WCP52/synthesizer/testing/steps.jpg

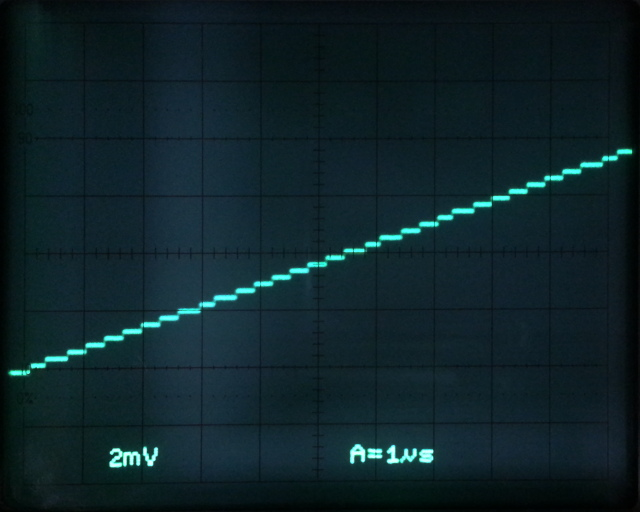
testing/steps.jpg
