WCP52/synthesizer/README.md

AD9958-based synthesizer board
==============================
