WCP52/synthesizer/pcb/renders/ad9958-dev_small.png

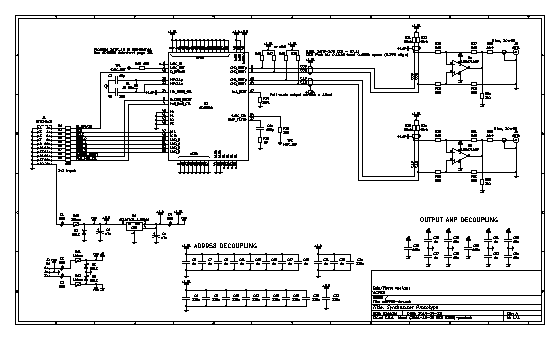
pcb/renders/ad9958-dev_small.png
