WCP52/synthesizer/pcb/renders/page_ad9958-dev.png

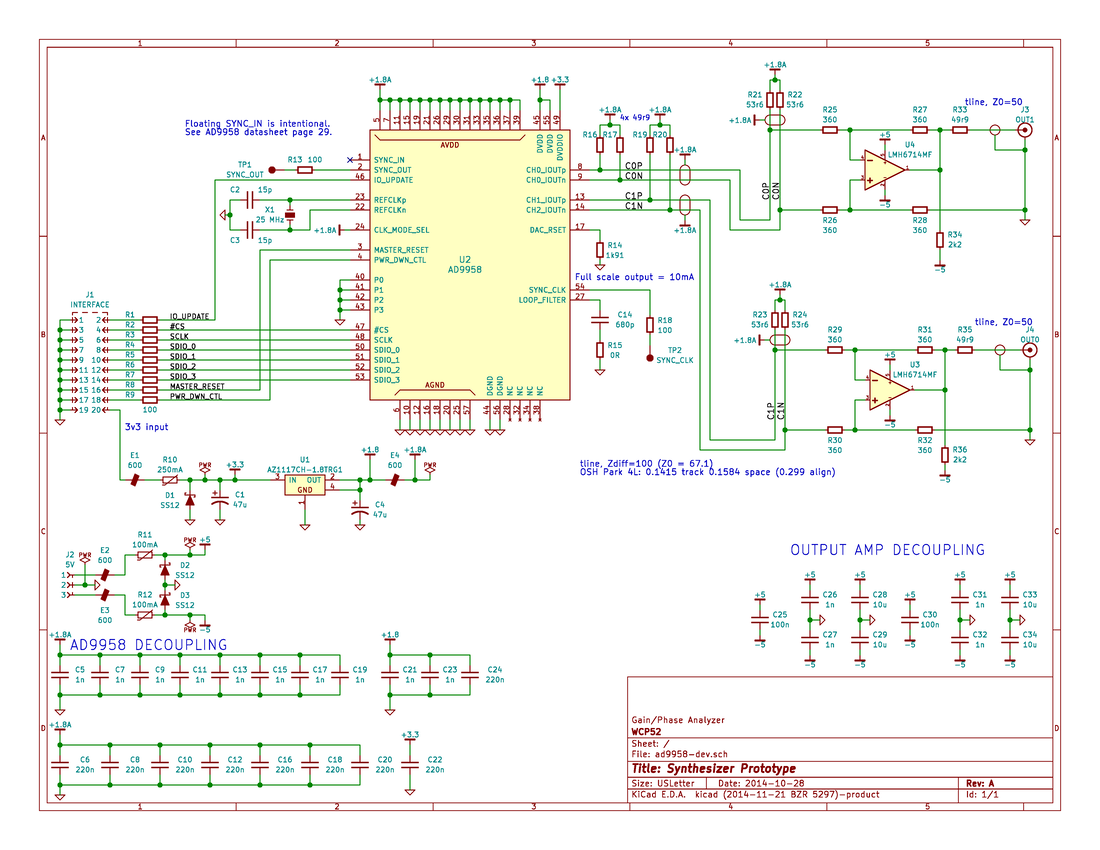
pcb/renders/page_ad9958-dev.png
