WCP52/synthesizer/pcb/renders/render_2l.png

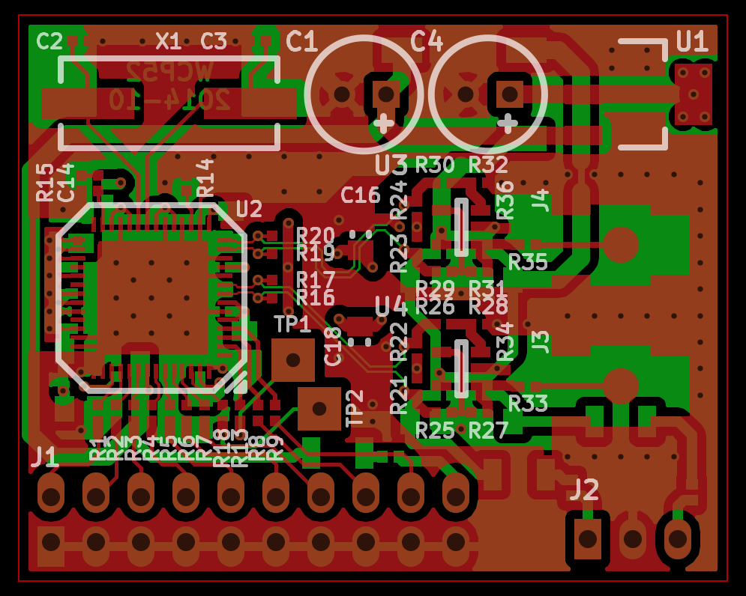
pcb/renders/render_2l.png
