WCP52/synthesizer/pcb/renders/render_3d_small.png

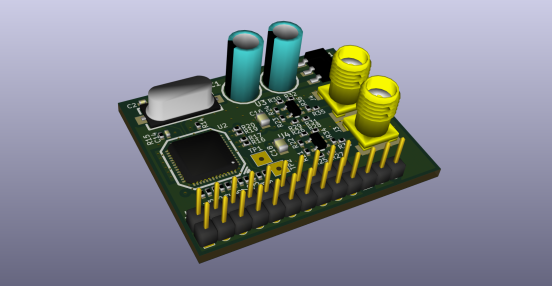
pcb/renders/render_3d_small.png
