WCP52/synthesizer/pcb/renders/render_lyr1.png

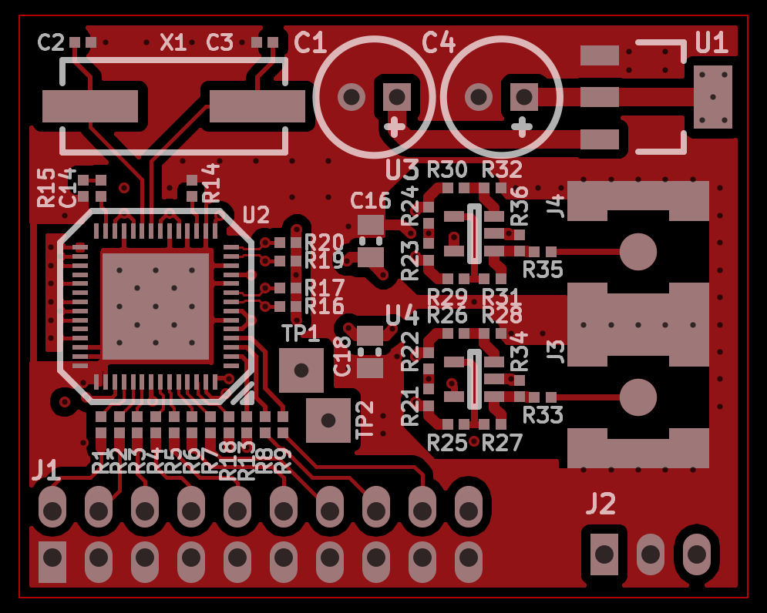
pcb/renders/render_lyr1.png
