WCP52/synthesizer/pcb/renders/render_lyr2.png

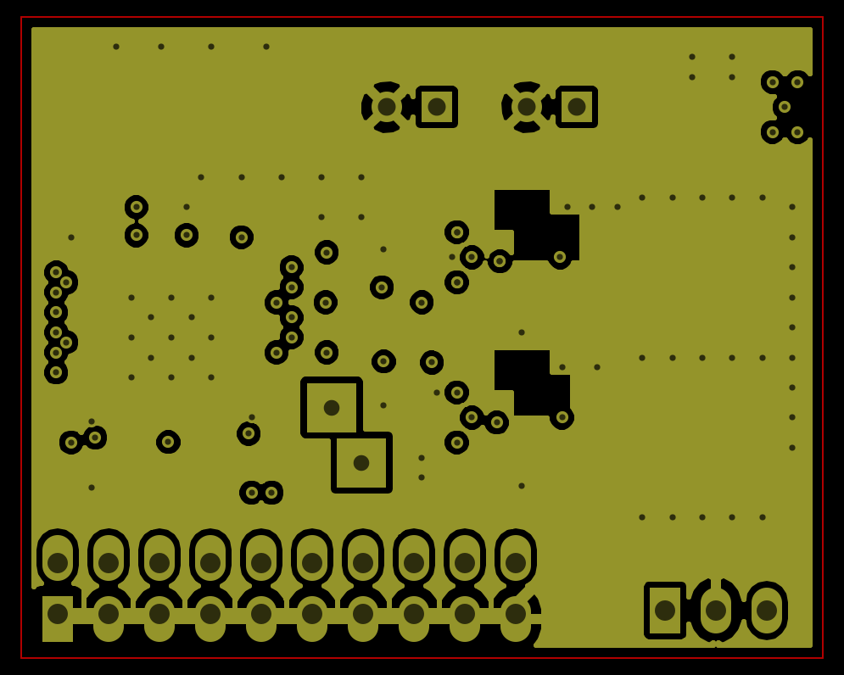
pcb/renders/render_lyr2.png
