WCP52/synthesizer/pcb/renders/render_lyr3.png

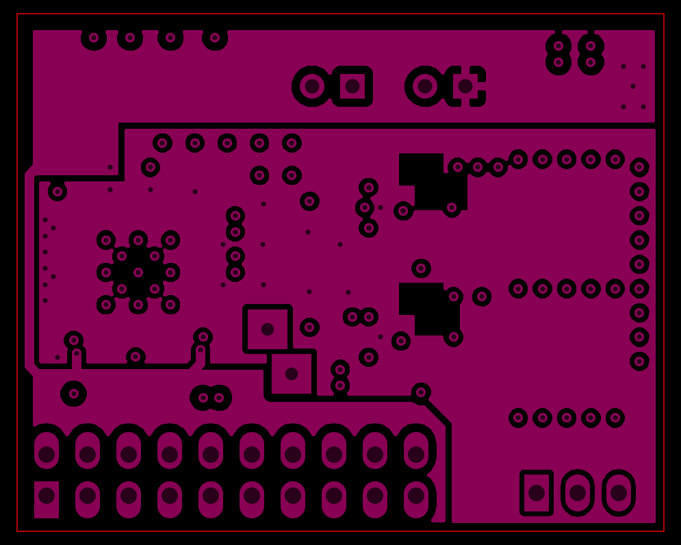
pcb/renders/render_lyr3.png
