WCP52/synthesizer/pcb/renders/render_lyr4.png

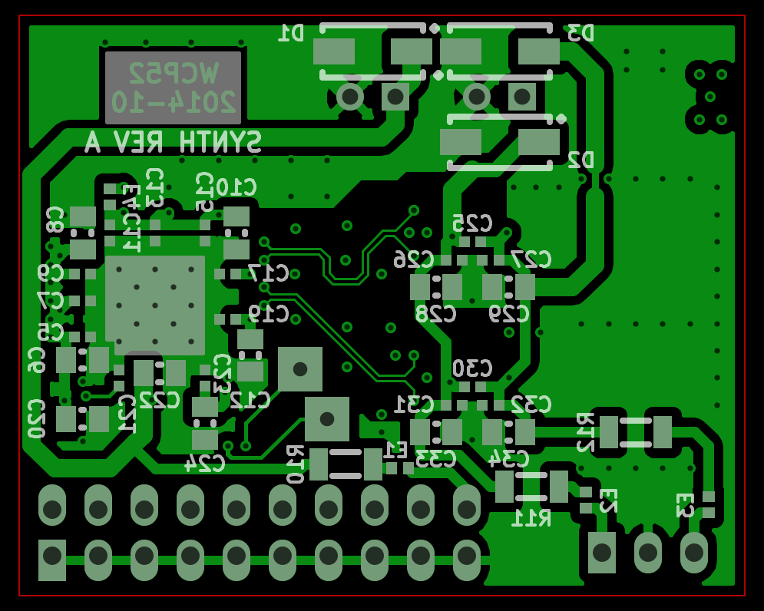
pcb/renders/render_lyr4.png
