WCP52/synthesizer/pcb/renders/schematic_small.png

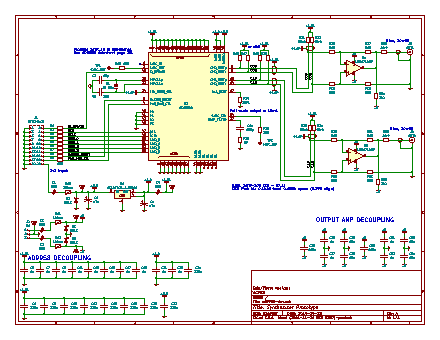
pcb/renders/schematic_small.png
