WCP52/synthesizer/pcb/renders/schematic.pdf

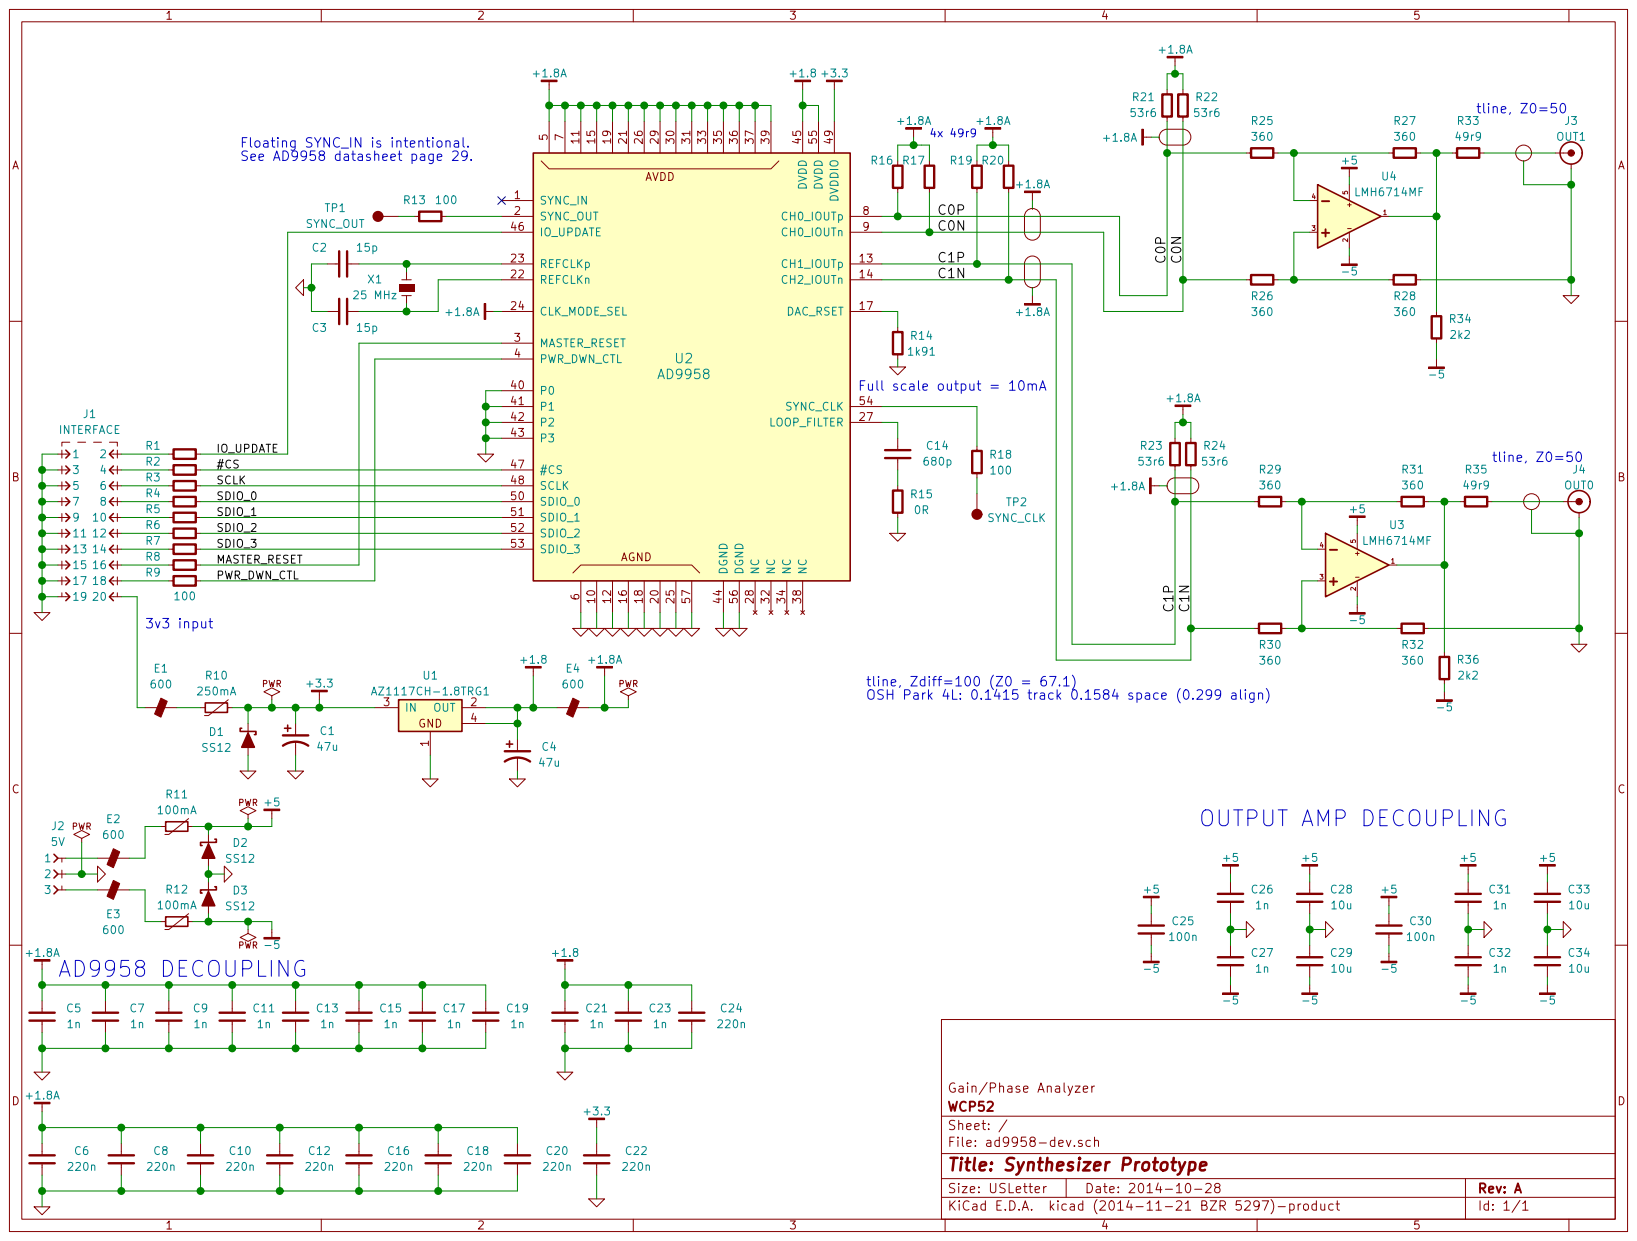
[picture p11: page 1]
