WCP52/synthesizer/sim/Draft1.asc

I1: load2; SINE(5m 5m {freq}); AC 1; load
I2: load2; SINE(5m 5m {freq} 0 0 180); AC 1 180; load
R1: res; 53.6
R2: res; 360
R3: res; 360
R4: res; 2k2
R5: res; 53.6
R11: res; 49.9
R14: res; 49.9
R17: res; 360
R19: res; 360
R20: res; 50
R21: res; 50
T2: tline; Td=1n Z0=100
U1: LMH6720
V1: voltage; 3.3
V2: voltage; 1.8
V3: voltage; 5
V4: voltage; -5
V6: voltage; 1.3
Named nets: 0, +3V3, +1V8, comp_limit, +5, -5, chp, chn, oa_inn, oa_inp, out
.tran {10/freq} uic
;ac dec 500 10 1G
;step param freq list 200 2k 20k 200k 2Meg 20Meg 200Meg
.param freq 200Meg
