WCP52/synthesizer/pcb/ad9958-dev.kicad_pcb

## KiCad design pcb/ad9958-dev.kicad_pcb (2014-11-11)

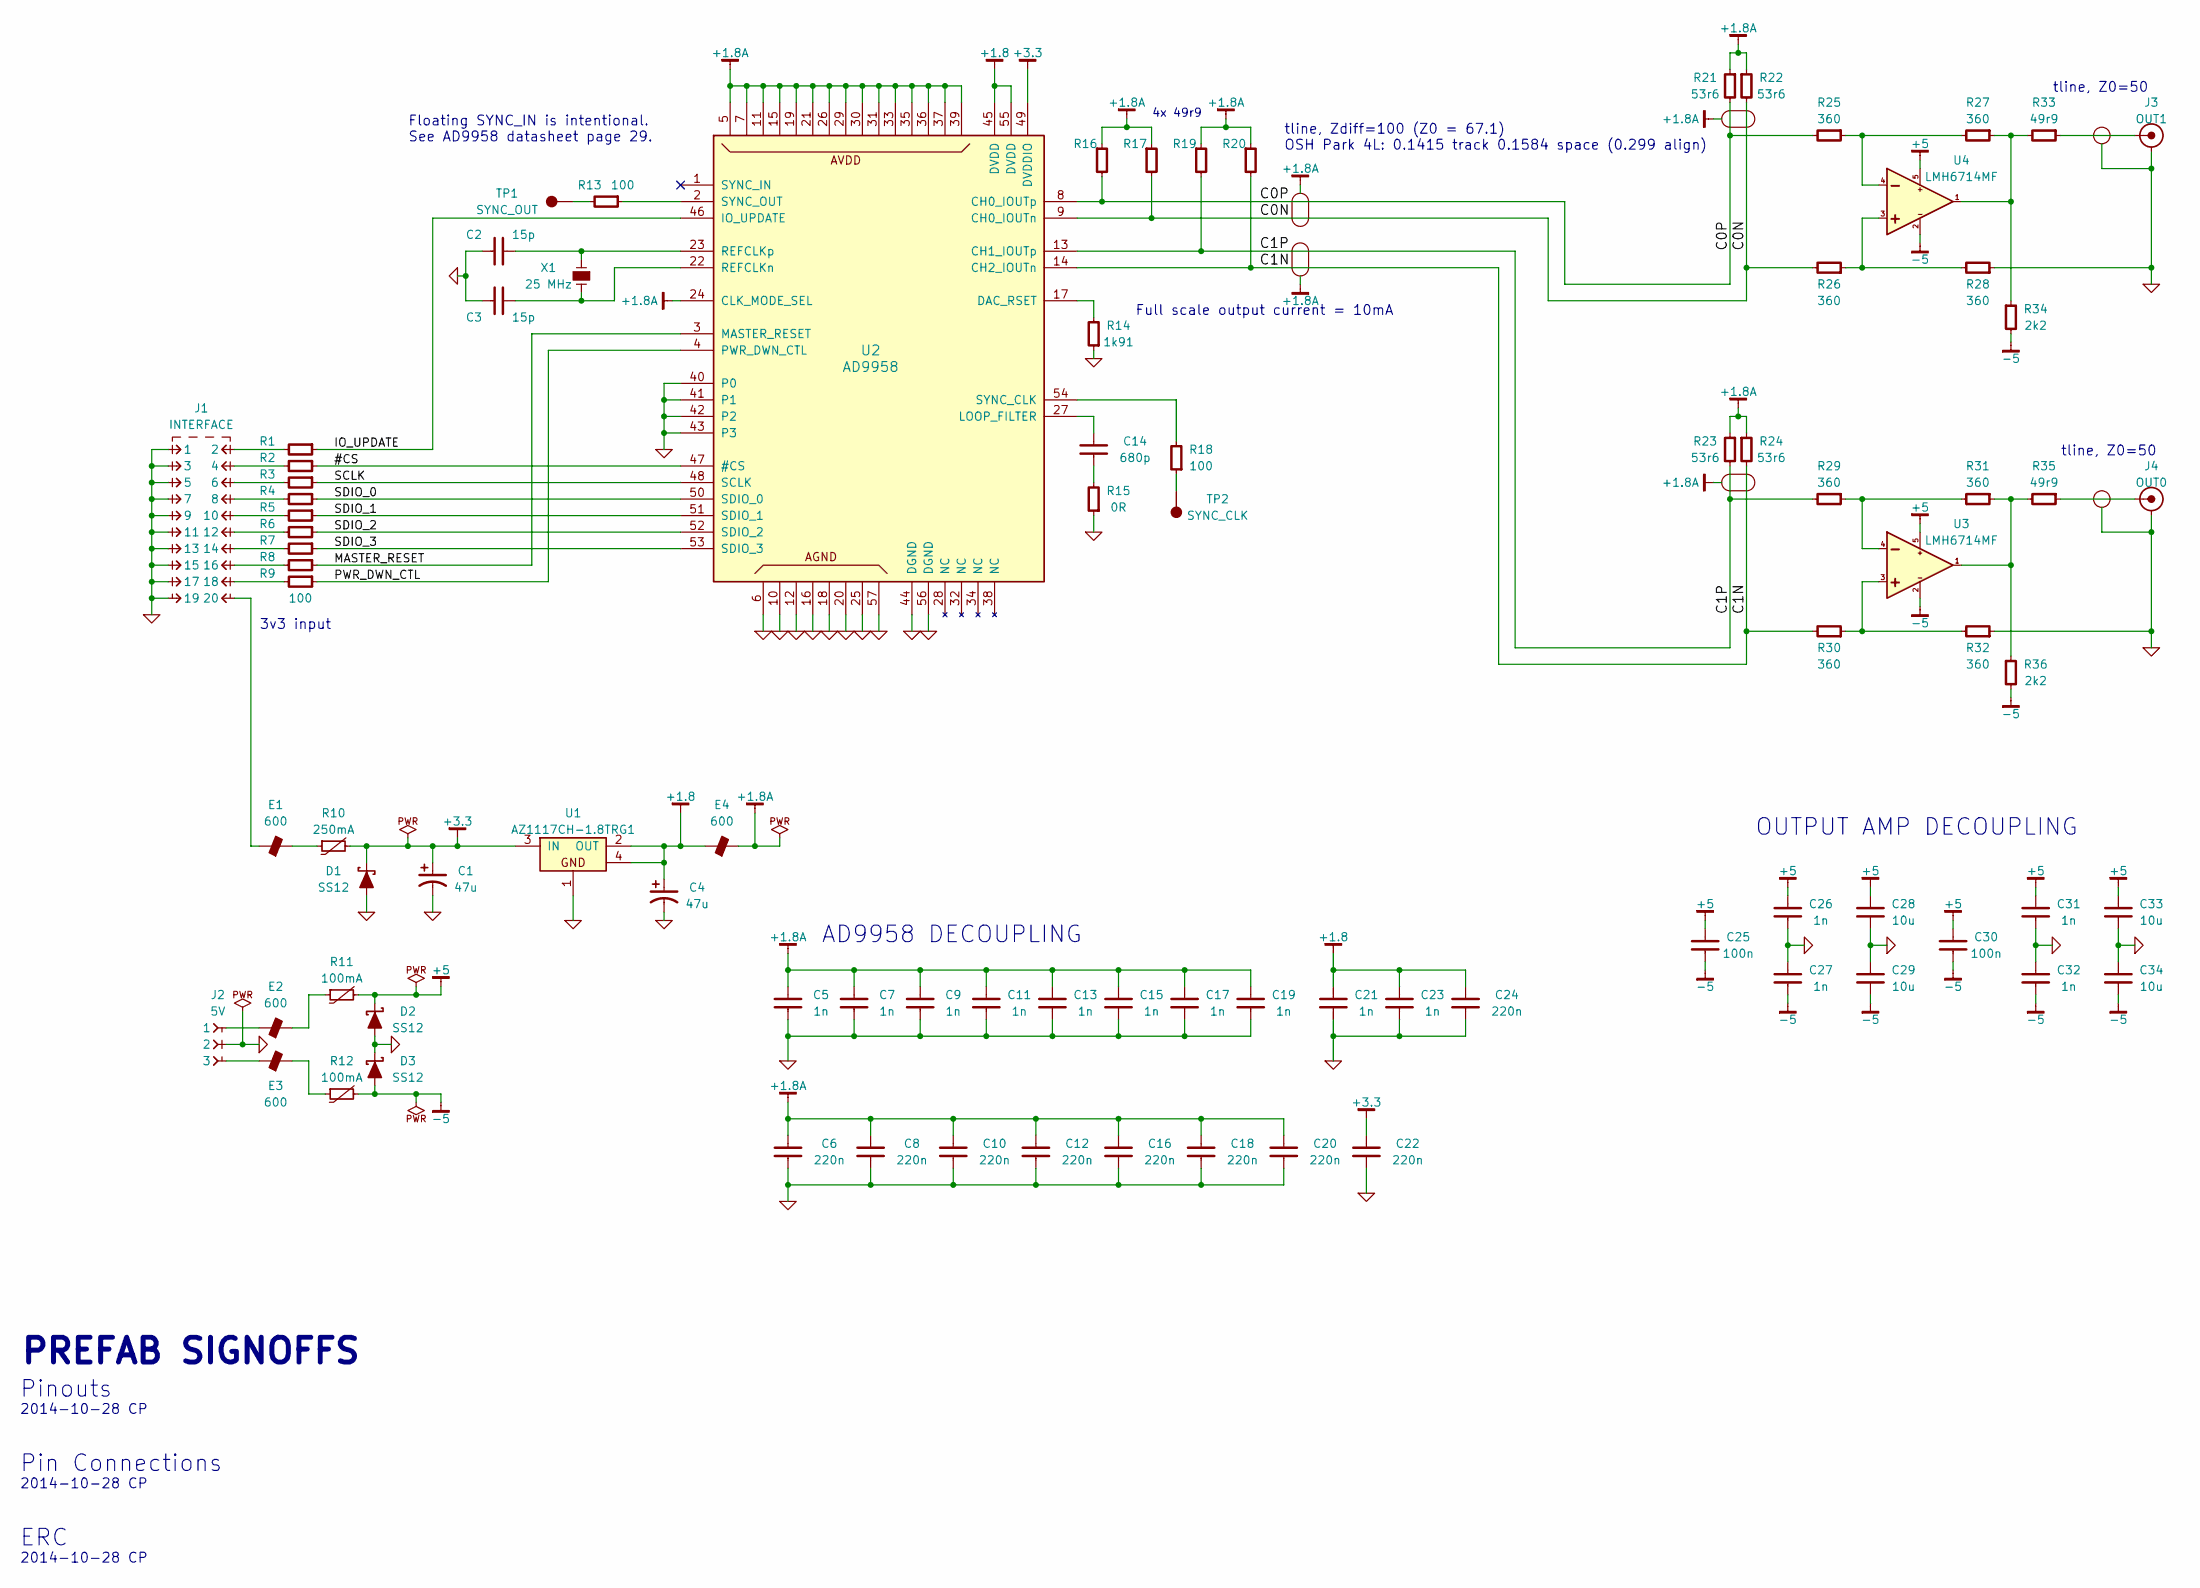
[picture p12: schematic ad9958-dev.sch, Synthesizer Prototype]

Parts:
C1, C4: 47u; C-ALUM-6.3mm
C2, C3: 15p; CAPC1005X55
C5, C7, C9, C11, C13, C15, C17, C19, C21, C23, C26, C27, C31, C32: 1n; CAPC1005X55
C6, C8, C10, C12, C16, C18, C20, C22, C24: 220n; CAPC2012X70
C14: 680p; CAPC1005X55
C25, C30: 100n; CAPC1005X55
C28, C29, C33, C34: 10u; CAPC2012X70
D1, D2, D3: SS12; DIOM5326X292
E1, E2, E3, E4: 600; INDC1005X60
J1: INTERFACE; CONN_20-DIL
J2: 5V; CONN_3-SIL
J3: OUT1; CONN-2_CONSMA001-SMD-G
J4: OUT0; CONN-2_CONSMA001-SMD-G
R1, R2, R3, R4, R5, R6, R7, R8, R9, R13, R18: 100; RESC1005X40
R10: 250mA; RESC3216X60
R11, R12: 100mA; RESC3216X60
R14: 1k91; RESC1005X40
R15: 0R; RESC1005X40
R16, R17, R19, R20, R33, R35: 49r9; RESC1005X40
R21, R22, R23, R24: 53r6; RESC1005X40
R25, R26, R27, R28, R29, R30, R31, R32: 360; RESC1005X40
R34, R36: 2k2; RESC1005X40
TP1: SYNC_OUT; TEST_SMD
TP2: SYNC_CLK; TEST_SMD
U1: AZ1117CH-1.8TRG1; SOT-223
U2: AD9958; LFCSP_VQ_56_ADI
U3, U4: LMH6714MF; SOT-23-5
X1: 25 MHz; XTAL1200X480X460

Connections:
+1.8: C4.1, C21.1, C23.1, C24.1, E4.2, U1.2 (OUT), U1.4, U2.45 (DVDD), U2.55 (DVDD)
/#CS: R2.1, U2.47 (#CS)
/C0N: R17.2, R22.2, R26.2, U2.9 (CH0_IOUTn)
/C0P: R16.2, R21.2, R25.2, U2.8 (CH0_IOUTp)
/C1N: R20.2, R24.2, R30.2, U2.14 (CH2_IOUTn)
/C1P: R19.2, R23.2, R29.2, U2.13 (CH1_IOUTp)
/IO_UPDATE: R1.1, U2.46 (IO_UPDATE)
/MASTER_RESET: R8.1, U2.3 (MASTER_RESET)
/PWR_DWN_CTL: R9.1, U2.4 (PWR_DWN_CTL)
/SCLK: R3.1, U2.48 (SCLK)
/SDIO_0: R4.1, U2.50 (SDIO_0)
/SDIO_1: R5.1, U2.51 (SDIO_1)
/SDIO_2: R6.1, U2.52 (SDIO_2)
/SDIO_3: R7.1, U2.53 (SDIO_3)
unnamed: C2.1, U2.23 (REFCLKp), X1.1
unnamed: C3.1, U2.22 (REFCLKn), X1.2
unnamed: C14.1, U2.27 (LOOP_FILTER)
unnamed: C14.2, R15.2
unnamed: E1.1, R10.1
unnamed: E1.2, J1.20
unnamed: E2.1, R11.1
unnamed: E2.2, J2.1
unnamed: E3.1, R12.1
unnamed: E3.2, J2.3
unnamed: J1.2, R1.2
unnamed: J1.4, R2.2
unnamed: J1.6, R3.2
unnamed: J1.8, R4.2
unnamed: J1.10, R5.2
unnamed: J1.12, R6.2
unnamed: J1.14, R7.2
unnamed: J1.16, R8.2
unnamed: J1.18, R9.2
unnamed: J3.1, R33.1
unnamed: J4.1, R35.1
unnamed: R13.1, U2.2 (SYNC_OUT)
unnamed: R13.2, TP1.1
unnamed: R14.2, U2.17 (DAC_RSET)
unnamed: R18.1, TP2.1
unnamed: R18.2, U2.54 (SYNC_CLK)
unnamed: R25.1, R27.2, U4.4 (IN-)
unnamed: R26.1, R28.2, U4.3 (IN+)
unnamed: R27.1, R33.2, R34.1, U4.1 (OUT)
unnamed: R29.1, R31.2, U3.4 (IN-)
unnamed: R30.1, R32.2, U3.3 (IN+)
unnamed: R31.1, R35.2, R36.1, U3.1 (OUT)

Notes on the sheet:
Full scale output current = 10mA
4x 49r9
tline, Zdiff=100 (Z0 = 67.1) OSH Park 4L: 0.1415 track 0.1584 space (0.299 align)
tline, Z0=50
AD9958 DECOUPLING
OUTPUT AMP DECOUPLING
3v3 input
Floating SYNC_IN is intentional. See AD9958 datasheet page 29.
PREFAB SIGNOFFS
Pinouts
2014-10-28 CP
Pin Connections
ERC

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
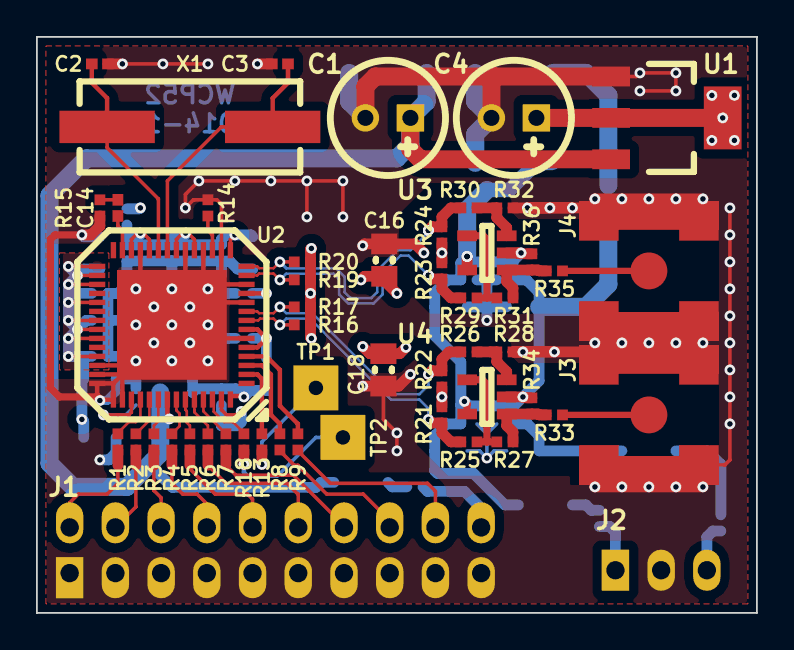
[picture p13: board ad9958-dev.kicad_pcb from above]

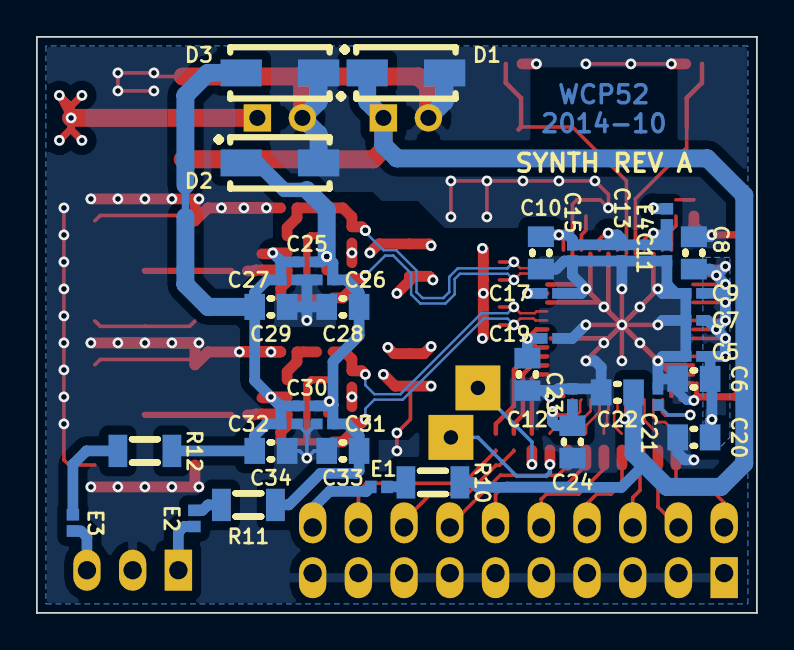
[picture p14: board ad9958-dev.kicad_pcb from below]

Board: 4 copper layers, 40.0 x 32.0 mm, 88 parts (37 on the bottom side), 51 nets.
