WCP52/synthesizer/testing/1khz-fft-1khzdiv.png

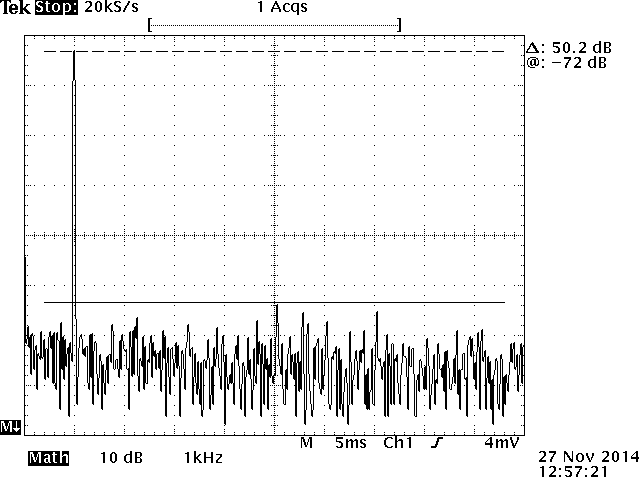
testing/1khz-fft-1khzdiv.png
