WCP52/synthesizer/testing/1khz-fft-50mhzdiv.png

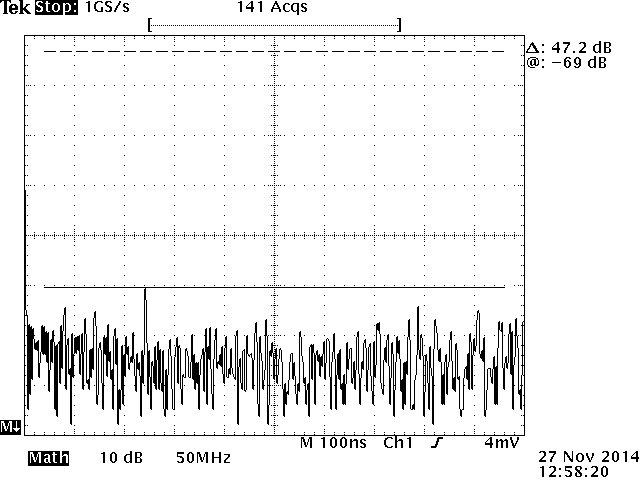
testing/1khz-fft-50mhzdiv.png
