WCP52/synthesizer/testing/1khz.png

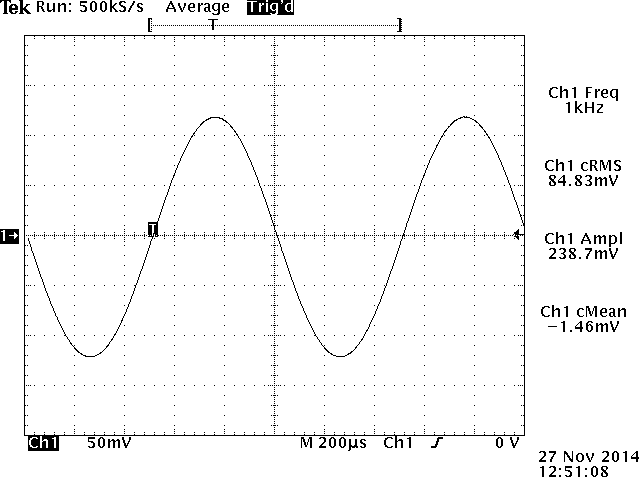
testing/1khz.png
