WCP52/synthesizer/testing/50mhz-fft-50mhzdiv.png

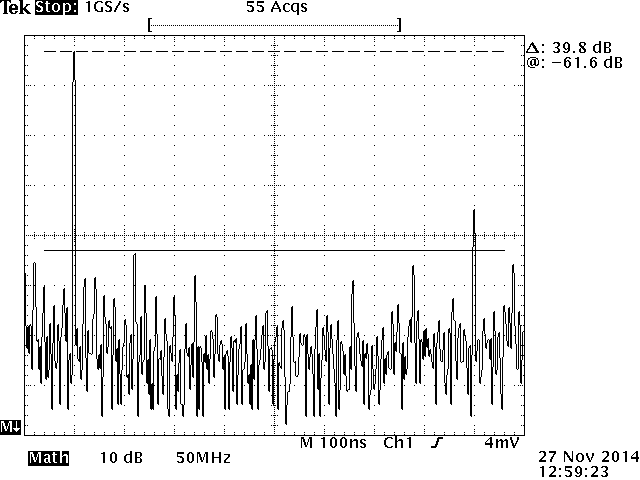
testing/50mhz-fft-50mhzdiv.png
