WCP52/synthesizer/testing/100Mhz.png

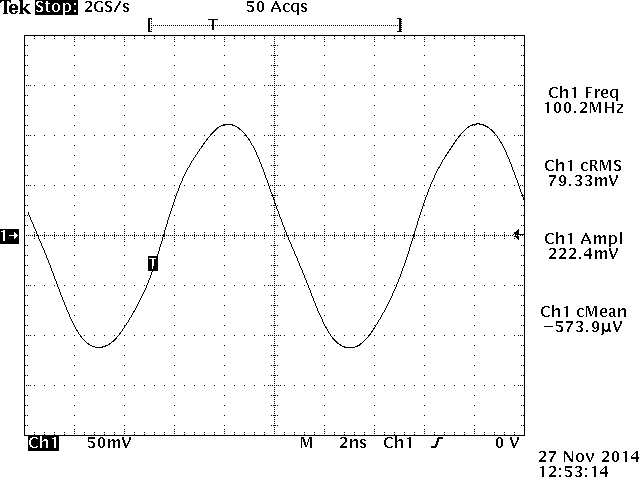
testing/100Mhz.png
