WCP52/synthesizer/testing/150mhz-fft-50mhzdiv.png

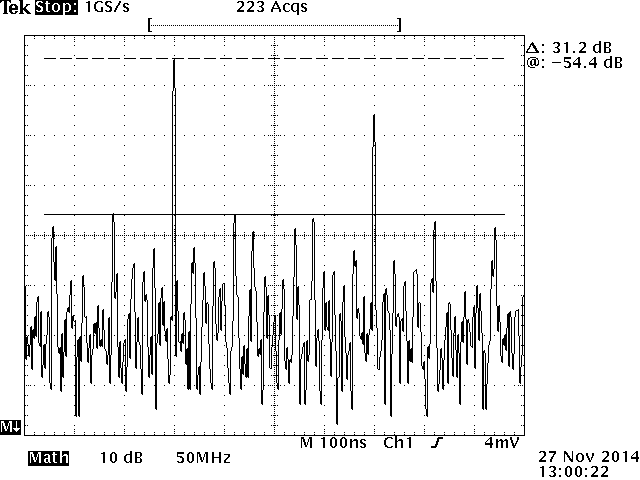
testing/150mhz-fft-50mhzdiv.png
