WCP52/synthesizer/testing/150Mhz.png

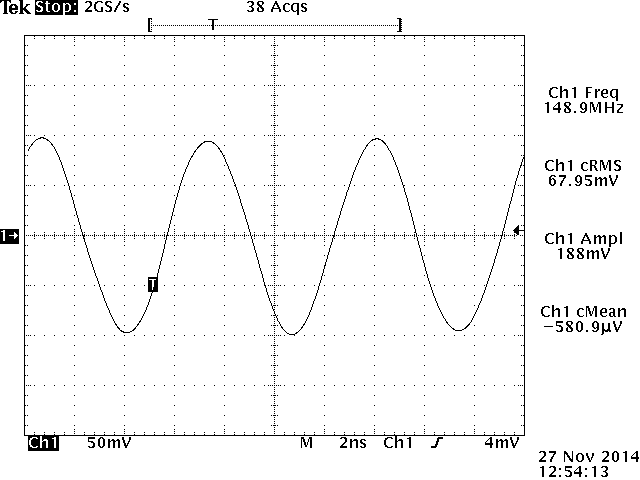
testing/150Mhz.png
