WCP52/synthesizer/(commit log)

2014-10-25 Put in very early schematic.
    [ad9958-dev.kicad_pcb, ad9958-dev.sch]
2014-10-25 More schematic work - should be ready for layout
    [ad9958-dev.sch]
2014-10-26 PCB almost done
    [ad9958-dev.kicad_pcb, ad9958-dev.sch]
2014-10-27 Updated AD9958 footprint.
    Still have to re-route a couple signals
    [ad9958-dev.kicad_pcb]
2014-10-28 Added power protection, touched up PCB
    [ad9958-dev.kicad_pcb, ad9958-dev.sch]
2014-10-28 Few part value changes
    Added voltage to LDO
    Changed 10nF to 1nF caps - eliminated BOM item
    [ad9958-dev.sch]
2014-10-28 PCB touchups
    [ad9958-dev.kicad_pcb]
2014-10-28 Schematic touchups
    [ad9958-dev.kicad_pcb, ad9958-dev.sch]
2014-10-28 PCB fixes
    [ad9958-dev.kicad_pcb]
2014-10-28 Added Gerber processing and rendering
    [ad9958-dev.GBL, ad9958-dev.GBO, ad9958-dev.GBS, ad9958-dev.GKO, ad9958-dev.GTL, ad9958-dev.GTO, ad9958-dev.GTS, ad9958-dev.XLN]
2014-10-28 Reannotated components
    [ad9958-dev.GBL, ad9958-dev.GBO, ad9958-dev.GBS, ad9958-dev.GKO, ad9958-dev.GTL, ad9958-dev.GTO, ad9958-dev.GTS, ad9958-dev.XLN]
2014-10-28 Prefab signoffs - CP
    [ad9958-dev.GBL, ad9958-dev.GBO, ad9958-dev.GBS, ad9958-dev.GKO, ad9958-dev.GTL, ad9958-dev.GTO, ad9958-dev.GTS, ad9958-dev.XLN]
2014-10-28 Added schematic render
2014-10-29 Adjusted diff pair routing
    Minor PCB appearance tweak
    [ad9958-dev.GBL, ad9958-dev.GBO, ad9958-dev.GBS, ad9958-dev.GKO, ad9958-dev.GTL, ad9958-dev.GTO, ad9958-dev.GTS, ad9958-dev.XLN]
2014-10-29 Tidied up simulation schematic
2014-10-30 Re-exported PCB
    [ad9958-dev-B_Cu.gbl, ad9958-dev-B_Mask.gbs, ad9958-dev-B_SilkS.gbo, ad9958-dev-Edge_Cuts.gbr, ad9958-dev-F_Cu.gtl, ad9958-dev-F_Mask.gts, ad9958-dev-F_SilkS.gto, ad9958-dev-In1_Cu.gbr]
2014-10-30 Gerber postprocessing
    [ad9958-dev-B_Cu.gbl, ad9958-dev-B_Mask.gbs, ad9958-dev-B_SilkS.gbo, ad9958-dev-Edge_Cuts.gbr, ad9958-dev-F_Cu.gtl, ad9958-dev-F_Mask.gts, ad9958-dev-F_SilkS.gto, ad9958-dev-In1_Cu.gbr]
2014-10-30 Gerber export
    [ad9958-dev-B_Cu.gbl, ad9958-dev-B_Mask.gbs, ad9958-dev-B_SilkS.gbo, ad9958-dev-Edge_Cuts.gbr, ad9958-dev-F_Cu.gtl, ad9958-dev-F_Mask.gts, ad9958-dev-F_SilkS.gto, ad9958-dev-In1_Cu.gbr]
2014-11-11 Adjusted postprocessing scripts - more generic
    [ad9958-dev.GBL, ad9958-dev.GBO, ad9958-dev.GBS, ad9958-dev.GKO, ad9958-dev.GTL, ad9958-dev.GTO, ad9958-dev.GTS, ad9958-dev.XLN]
2014-11-29 Updated schematic render
    [ad9958-dev.sch]
